aidanmorgan/morsdle/ioc/morsdle/Core/Src/main.c

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
/* Includes ------------------------------------------------------------------*/
#include "main.h"

/* USER CODE BEGIN Includes */
#include "stm32l4_conf.h"
/* USER CODE END Includes */

 QSPI_HandleTypeDef hqspi;

RNG_HandleTypeDef hrng;

SPI_HandleTypeDef hspi2;

TIM_HandleTypeDef htim1;

UART_HandleTypeDef huart4;
UART_HandleTypeDef huart2;

void SystemClock_Config(void);
static void MX_GPIO_Init(void);
static void MX_SPI2_Init(void);
static void MX_USART2_UART_Init(void);
static void MX_TIM1_Init(void);
static void MX_RNG_Init(void);
static void MX_UART4_Init(void);
static void MX_QUADSPI_Init(void);
/**
  * @brief  The application entry point.
  * @retval int
  */

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
/* USER CODE BEGIN 4 */
void init_stm32l476()
{
    // this does what the typically generated STM32CubeMX main line does
    HAL_Init();
    SystemClock_Config();
    MX_GPIO_Init();
    MX_SPI2_Init();
    MX_USART2_UART_Init();
    MX_TIM1_Init();
    MX_RNG_Init();
    MX_QUADSPI_Init();
    MX_UART4_Init();
}

/* USER CODE END 4 */
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
