aidanmorgan/morsdle/ioc/morsdle/morsdle.ioc

Mcu.UserName=STM32L476RGTx
PA0.Signal=UART4_TX
PA1.Signal=UART4_RX
PA12.GPIO_Label=MorseKey
PA12.Signal=GPXTI12
PA2.GPIO_Label=USART_TX
PA2.Signal=USART2_TX
PA3.GPIO_Label=USART_RX
PA3.Signal=USART2_RX
PA5.GPIO_Label=LD2 [green Led]
PA5.Signal=GPIO_Output
PA6.Signal=QUADSPI_BK1_IO3
PA7.Signal=QUADSPI_BK1_IO2
PB0.Signal=QUADSPI_BK1_IO1
PB1.Signal=QUADSPI_BK1_IO0
PB10.Signal=QUADSPI_CLK
PB11.Signal=QUADSPI_NCS
PB13.Signal=SPI2_SCK
PC1.GPIO_Label=StartupMode
PC1.Signal=GPIO_Input
PC13.GPIO_Label=B1 [Blue PushButton]
PC13.Signal=GPXTI13
PC2.Signal=SPI2_MISO
PC3.Signal=SPI2_MOSI
PC6.GPIO_Label=BUSY
PC6.Signal=GPIO_Input
PC7.GPIO_Label=DC
PC7.Signal=GPIO_Output
PC8.GPIO_Label=RST
PC8.Signal=GPIO_Output
PC9.GPIO_Label=SPI_CS
PC9.Signal=GPIO_Output
