aidanmorgan/morsdle/ioc/morsdle/Core/Inc/main.h

#define B1_Pin GPIO_PIN_13
#define B1_GPIO_Port GPIOC
#define B1_EXTI_IRQn EXTI15_10_IRQn
#define StartupMode_Pin GPIO_PIN_1
#define StartupMode_GPIO_Port GPIOC
#define USART_TX_Pin GPIO_PIN_2
#define USART_TX_GPIO_Port GPIOA
#define USART_RX_Pin GPIO_PIN_3
#define USART_RX_GPIO_Port GPIOA
#define LD2_Pin GPIO_PIN_5
#define LD2_GPIO_Port GPIOA
#define BUSY_Pin GPIO_PIN_6
#define BUSY_GPIO_Port GPIOC
#define DC_Pin GPIO_PIN_7
#define DC_GPIO_Port GPIOC
#define RST_Pin GPIO_PIN_8
#define RST_GPIO_Port GPIOC
#define SPI_CS_Pin GPIO_PIN_9
#define SPI_CS_GPIO_Port GPIOC
#define MorseKey_Pin GPIO_PIN_12
#define MorseKey_GPIO_Port GPIOA
#define MorseKey_EXTI_IRQn EXTI15_10_IRQn
#define TMS_Pin GPIO_PIN_13
#define TMS_GPIO_Port GPIOA
#define TCK_Pin GPIO_PIN_14
#define TCK_GPIO_Port GPIOA
#define SWO_Pin GPIO_PIN_3
#define SWO_GPIO_Port GPIOB
