aidanmorgan/morsdle/(commit log)

2022-04-21 Changed implementation of rendering to use a plugged-in driver to implement the waveshare epaper display, will implement a "render to file" approach in a moment.
2022-05-05 Added more logic and unit tests for more boundary cases to try and ensure that the code will work one day when I get near a STM board again.
2022-05-27 WIP on changing how the renderer works to work in a "dirty region" approach rather than redrawing everything constantly (first attempt - super duper gross and slow), and also rather than using a doub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
    I have broken pretty much everything at the moment.
    [main.c]
2022-05-29 Slowly wokring through the pain that I introduced by making regions, unit tests are back passing, there's still a bit of a strange-loop with the display stuff - I may have added too much abstraction 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
    [main.c]
2022-05-31 WIP on the STM32 integration, trying to work out the correct pins and configurations.
    [main.c, waveshare_stm.c, waveshare_stm.h]
2022-06-02 Reworking the STM32 initialisation code.
    [main.c, waveshare_stm.h]
2022-06-03 Reworking how STM is integrated to the project. Using the code that is generated from the CubeMX and incorproating it into the morsdle main
    [main.c, morsdle.ioc, morsdle_main.c]
2022-06-03 I'll just admit it now, I've completely sold out and am using the STM32CubeMX generated code because apparently it's too much to ask for a nicely defined API to work with.
    [main.c, main.h, morsdle.ioc, morsdle_main.c]
2022-06-04 Reworking how the ports/pins/handles are accessed from the STM32CubeMX generated code, by adding an init function that takes in a struct of handles that are available to the main loop.
    [main.c, main.h, morsdle_main.c]
2022-06-04 Working on linking issues (fuck i hate linkers, they are a nightmare) Added an implementation of the long-hold reset functionality so I at least feel like I achieved something with this commit. Added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
    [main.c, main.h, morsdle_main.c]
2022-06-05 Working through using OpenOCD to perform debugging via GDB
    [st_nucleo_l4.cfg]
2022-06-05 My battery is about to die, so I am pushing to swap computers
    [morsdle_main.c]
2022-06-05 Updating rendering code so the image buffer fits in memory. Added missing stm32 interrupt .c code that was generated by STM32CubeMX that was not included in the build which caused interrupts to not o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
    [main.c, morsdle.ioc, morsdle_main.c]
2022-06-07 At some point during this development I swapped from using opaque pointers to just pointers and I have confused the shit out of myself, so I've made everything pointers to not confuse myself.
    Started working on a 2-bit colour implementation of the image buffer as we only use 4 colours and the STM32L476RG I am using doesn't have enough heap space to store an image buffer of 4-bit colours.
    [main.c]
2022-06-07 Reworking the 2-bit colour imagebuffer idea some more, it appears to work?
    [morsdle_main.c]
2022-06-07 Continued rework on trying to clean up the API layer to remove dependencies between layers
    [morsdle_main.c]
2022-06-08 So turns out that insomnia means that you end up rewriting your morse parser at 2am, and then spending another 3 hours rewriting unit tests because apparently you were drunk the first time you wrote 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
    Morse seems to work on the STM32 now according to the debugger, still NFI why the display isn't working.
    Enabled QuadSPI in the HAL as well as it's likely going to be used for external NOR flash storage for loading fonts and the wordle dictionary from, but that is a whole other world of pain to be encountered in the future.
2022-06-14 WIP - tryng to debug the display issue with an OScope :-/ You know bad things are going to happen.
    [game.c, loader.c, main.c, morsdle.ioc, morsdle_main.c]
2022-06-19 Got the display working! I will never ever admit what it was that was wrong, because I would look really dumb.
    [game.c, loader.c, main.c, main.h, morsdle.ioc, morsdle_main.c]
2022-06-20 Went back to the SPI based design for intergrating with the STM board and waveshare display after I realised the completely moronic bug that was stopping the board from working.
    [game.c, morsdle_main.c]
2022-06-20 Got it all rendering correctly, now to remove the hard-coded word entry and check that it works with actual morse code input!
    [game.c]
2022-06-25 Got orange squares rendering on the display correctly.
    [game.c]
2022-06-26 Added a hardware debounce so I can use a reed switch with a longer arm as a morse key.
